riverspy/riverspy5/README.md

# riverspy5
Riverspy system based on the arduino compatible GBoard800, a custom daugher-board pcb which pushes onto the GBoard and either a tfmini LIDAR sensor or else a submersible differential pressure sensor.

Find the latest code on Github:
https://github.com/riverspy/riverspy5
