riverspy/riverspy5/hardware/daughter-board.png

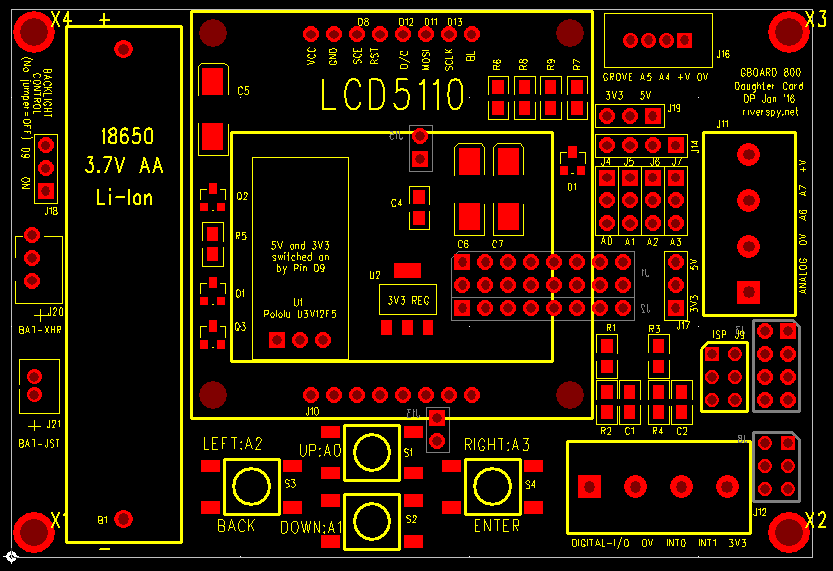
hardware/daughter-board.png
