riverspy/riverspy5/hardware/RiverSpy5-BOM.xls

Sheet: Sheet1
NOTES:
1, Manufacture Part Number is critical. Customers should provide the exact MPN.
2, Components Supplier: Digi-Key，Mouser，Element14，Chip One Stop，Verical，P&S，MCM，Newark，Gerber，Future，Avnet Arrow，Wpi，Master，Onlinecomponents.com，TTI，Garrett，4Stat，Allied，AIPCO，Sierra IC，Advanced MP Technology，Components Direct，Bristol，Bisco，Quest Components，Area51，Coilcraft
3, We only source components from the listed suppliers. If the components can not be sourced from the above suppliers, customers should find a replacement or ship the components to us.
4, We recommend to use Yageo resistors, we can get a better price for customers. Here's the part number:
http://www.digikey.com/product-search/en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
http://www.digikey.com/product-search/en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
Ref | Value | Footprint | Manufacture | Manufacture Part Number | Quantity | Specification
C1, C9, C12, C13, C15, C18, C25, C26, C27 | 10uF,10%,50 V | 1210 | AVX | 12105C106KAT2A | 9 | http://no.farnell.com/avx/12105c106kat2a/cap-mlcc-x7r-10uf-50v-1210/dp/2094047?ost=2094047
C2, C3, C4, C7, C14, C35, C36, C39, C42, C43, C46 | 47uF, 20%, 16V | 1210 | KEMET | C1210C476M4PACTU | 11 | http://no.farnell.com/kemet/c1210c476m4pactu/cap-mlcc-x5r-47uf-16v-1210/dp/1838761?ost=1838761
D1-D24, D37-D48, D50 | SCHOTTKY, 5A, 40V | SOD-128 | NXP | PMEG4050EP | 37 | http://no.farnell.com/nxp/pmeg4050ep/diode-schottky-5a-40v-sod-128/dp/1829203?Ntt=1829203
D49 | SCHOTTKY, 1A, 45V | SMA | VISHAY | BYS10-45-E3/TR | 1 | http://no.farnell.com/vishay/bys10-45-e3-tr/diode-schottky-1a-45v-sma/dp/1815642?Ntt=1815642
LED3, 5, 7, 9, 11, 13, 21, 23, 25, 28 | SMD, GREEN | 1206 | KINGBRIGHT | KP-3216MGC | 10 | http://no.farnell.com/kingbright/kp-3216mgc/led-smd-1206-green/dp/8529981?Ntt=8529981
U1 | REG LDO, 3.3V, 1.5A | DPAK | STMICROELECTRONICS | LD29150DT33R | 1 | http://no.farnell.com/stmicroelectronics/ld29150dt33r/ic-reg-ldo-3-3v-1-5a-dpak/dp/1564308?Ntt=1564308
R1,R2,R3 | RES 1K OHM 1/10W 5% 0603 SMD | 0603 | YAGEO | RC0603JR-071KL | 3 | http://www.digikey.com/product-detail/en/RC0603JR-071KL/311-1.0KGRCT-ND/729624

Sheet: Sheet2
Item | Qty | Reference | Part Name | Value | Footprint | Manufacturer | Part No | Specification
1 | 1 | Q1 | 2N7002LT1 | MOSFET N-ch 300mA 60V | SOT-23 | NXP | 2N7002,215 | http://ie.farnell.com/nxp/2n7002-215/mosfet-n-ch-60v-0-3a-sot23/dp/1510761
2 | 1 | Q3 | 2N7002LT1 | MOSFET N-ch 300mA 60V | SOT-23 | NXP | 2N7002,215 | http://ie.farnell.com/nxp/2n7002-215/mosfet-n-ch-60v-0-3a-sot23/dp/1510761
3 | 1 | B1 | BAT-AA | Single AA battery holder | 52mm pitch | Keystone | 2460 | http://ie.farnell.com/keystone/2460/battery-holder/dp/1702629
4 | 1 | D1 | BAT721C | Dual Schottky | SOT-23 | NXP | BAT721C | http://ie.farnell.com/nxp/bat721c/diode-schottky-dual/dp/1081199
5 | 1 | Q2 | BSS308PE | MOSFET P-ch -2A -30V | SOT-23 | Infineon | BSS308PE H6327 | http://ie.farnell.com/infineon/bss308pe-h6327/mosfet-p-ch-30v-2a-sot-23-3/dp/2432719
6 | 1 | C1 | CAP0805 | 10nF 50V Ceramic | 0805 | MultiComp | MC0805B103K500CT | http://ie.farnell.com/multicomp/mc0805b103k500ct/cap-mlcc-x7r-10nf-50v-0805/dp/1759246
7 | 1 | C2 | CAP0805 | 10nF 50V Ceramic | 0805 | MultiComp | MC0805B103K500CT | http://ie.farnell.com/multicomp/mc0805b103k500ct/cap-mlcc-x7r-10nf-50v-0805/dp/1759246
8 | 1 | C4 | CAP0805 | 10nF 50V Ceramic | 0805 | MultiComp | MC0805B103K500CT | http://ie.farnell.com/multicomp/mc0805b103k500ct/cap-mlcc-x7r-10nf-50v-0805/dp/1759246
9 | 1 | C5 | CAP6032 | 22uF 16V Tantalum | 2312 | Kemet | T491C226K016AT | http://ie.farnell.com/kemet/t491c226k016at/cap-tant-22uf-16v-case-c/dp/1457474
10 | 1 | C6 | CAP6032 | 22uF 16V Tantalum | 2312 | Kemet | T491C226K016AT | http://ie.farnell.com/kemet/t491c226k016at/cap-tant-22uf-16v-case-c/dp/1457474
11 | 1 | C7 | CAP6032 | 22uF 16V Tantalum | 2312 | Kemet | T491C226K016AT | http://ie.farnell.com/kemet/t491c226k016at/cap-tant-22uf-16v-case-c/dp/1457474
12 | 1 | J2 | HEADER08 | Receptacle 8x1 pins h:8.5mm | SIL-8 | MultiComp | 2212S-08SG-85 | http://ie.farnell.com/multicomp/2212s-08sg-85/socket-pcb-1-row-8way/dp/1593463?ost=1593463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
13 | 1 | J16 | GROVE-4PIN | Grove 4-pin connector | SIL-4-2mm | Seeed Studio | 110990030 | http://eu.mouser.com/ProductDetail/Seeed-Studio/110990030/
14 | 1 | J13 | HEADER02 | Receptacle 2x1 pins h:8.5mm | SIL-2 | MultiComp | 2212S-02SG-85 | http://ie.farnell.com/multicomp/2212s-02sg-85/receptacle-tht-vertical-2-54mm/dp/1593458
15 | 1 | J15 | HEADER02 | Receptacle 2x1 pins h:8.5mm | SIL-2 | MultiComp | 2212S-02SG-85 | http://ie.farnell.com/multicomp/2212s-02sg-85/receptacle-tht-vertical-2-54mm/dp/1593458
16 | 1 | J4 | HEADER03 | Header 3x1 pins | SIL-3 | Harwin | M20-9990346 | http://ie.farnell.com/harwin/m20-9990346/connector-header-tht-2-54mm-3way/dp/1022249
17 | 1 | J5 | HEADER03 | Header 3x1 pins | SIL-3 | Harwin | M20-9990346 | http://ie.farnell.com/harwin/m20-9990346/connector-header-tht-2-54mm-3way/dp/1022249
18 | 1 | J6 | HEADER03 | Header 3x1 pins | SIL-3 | Harwin | M20-9990346 | http://ie.farnell.com/harwin/m20-9990346/connector-header-tht-2-54mm-3way/dp/1022249
19 | 1 | J7 | HEADER03 | Header 3x1 pins | SIL-3 | Harwin | M20-9990346 | http://ie.farnell.com/harwin/m20-9990346/connector-header-tht-2-54mm-3way/dp/1022249
20 | 1 | J17 | HEADER03 | Header 3x1 pins | SIL-3 | Harwin | M20-9990346 | http://ie.farnell.com/harwin/m20-9990346/connector-header-tht-2-54mm-3way/dp/1022249
21 | 1 | J18 | HEADER03 | Header 3x1 pins | SIL-3 | Harwin | M20-9990346 | http://ie.farnell.com/harwin/m20-9990346/connector-header-tht-2-54mm-3way/dp/1022249
22 | 1 | J19 | HEADER03 | Header 3x1 pins | SIL-3 | Harwin | M20-9990346 | http://ie.farnell.com/harwin/m20-9990346/connector-header-tht-2-54mm-3way/dp/1022249
23 | 1 | J14 | HEADER04 | Header 4x1 pins | SIL-4 | Harwin | M20-9990446 | http://ie.farnell.com/harwin/m20-9990446/header-1row-4way/dp/1022251
24 | 1 | J1 | HEADER16-DIL | Receptacle 8x2 pins h:8.5mm | DIL-8 | Harwin | M20-7830846 | http://ie.farnell.com/harwin/m20-7830846/socket-pcb-0-1-8-8way/dp/7992017
25 | 1 | J8 | HEADER06-DIL | Receptacle 3x2 pins h:8.5mm | DIL-6 | Harwin | M20-7830346 | http://ie.farnell.com/harwin/m20-7830346/socket-pcb-0-1-3-3way/dp/7991983
26 | 1 | J9 | HEADER06-DIL | Header 3x2 pins | DIL-6 | Harwin | M20-9980346 | http://ie.farnell.com/harwin/m20-9980346/connector-header-tht-2-54mm-6way/dp/1022231
27 | 1 | J3 | HEADER08-DIL | Header 4x2 pins | DIL-8 | Harwin | M20-9980446 | http://ie.farnell.com/harwin/m20-9980446/header-2row-4way/dp/1022233
28 | 1 | J21 | JST-PH2 | Connector 2-pin 2.0mm | JST-PH2 | JST | B2B-PH-K-S(LF)(SN) | http://ie.farnell.com/jst-japan-solderless-terminals/b2b-ph-k-s-lf-sn/header-top-entry-2way-2mm/dp/9491856
29 | 1 | J20 | JST-XH2 | Connector 2-pin 2.5mm | JST-XH2 | JST | B2B-XH-A (LF)(SN) | http://ie.farnell.com/jst-japan-solderless-terminals/b2b-xh-a-lf-sn/header-vertical-2way/dp/1516276
30 | 1 | J10 | LCD5110 | Nokia LCD Display | 45x45mm | ITEAD | IM120424001 | https://www.itead.cc/nokia-5110-lcd.html
31 | 1 | J10a | HEADER08 | Receptacle 8x1 pins h:8.5mm | SIL-8 | MultiComp | 2212S-08SG-85 | http://ie.farnell.com/multicomp/2212s-08sg-85/socket-pcb-1-row-8way/dp/1593463?ost=1593463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
32 | 1 | J10b | HEADER08 | Receptacle 8x1 pins h:8.5mm | SIL-8 | MultiComp | 2212S-08SG-85 | http://ie.farnell.com/multicomp/2212s-08sg-85/socket-pcb-1-row-8way/dp/1593463?ost=1593463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
33 | 1 | U2 | MCP1824S | 3.3V Low dropout regulator | SOT-223 | Microchip | MCP1824ST-3302E/DB | http://ie.farnell.com/microchip/mcp1824st-3302e-db/ic-ldo-reg-0-3a-3-3v-3-sot223/dp/1578379RL
34 | 1 | U1 | STEP-UP-5V | 3 terminal step-up regulator 1A | TO-220 | POLOLU | U3V12F5 | https://www.pololu.com/product/2115
35 | 1 | R1 | RES0805 | 15k 1% | 0805
36 | 1 | R2 | RES0805 | 33k 1% | 0805
37 | 1 | R3 | RES0805 | 15k 1% | 0805
38 | 1 | R4 | RES0805 | 33k 1% | 0805
39 | 1 | R5 | RES0805 | 10k 5% | 0805
40 | 1 | R6 | RES0805 | 470R 5% | 0805
41 | 1 | R7 | RES0805 | 470R 5% | 0805
42 | 1 | R8 | RES0805 | Do not populate
43 | 1 | R9 | RES0805 | Do not populate
44 | 1 | S1 | SW-SMD | Tactile SMD pushbutton switch | 10x6.25mm | C&K Components | KSEK43G LFS | http://ie.farnell.com/c-k-components/ksek43g-lfs/tactile-switch-spst-0-05a-32vdc/dp/2435308
45 | 1 | S2 | SW-SMD | Tactile SMD pushbutton switch | 10x6.25mm | C&K Components | KSEK43G LFS | http://ie.farnell.com/c-k-components/ksek43g-lfs/tactile-switch-spst-0-05a-32vdc/dp/2435308
46 | 1 | S3 | SW-SMD | Tactile SMD pushbutton switch | 10x6.25mm | C&K Components | KSEK43G LFS | http://ie.farnell.com/c-k-components/ksek43g-lfs/tactile-switch-spst-0-05a-32vdc/dp/2435308
47 | 1 | S4 | SW-SMD | Tactile SMD pushbutton switch | 10x6.25mm | C&K Components | KSEK43G LFS | http://ie.farnell.com/c-k-components/ksek43g-lfs/tactile-switch-spst-0-05a-32vdc/dp/2435308
48 | 1 | J11 | TERM-4WAY | 4-way terminal block p:5.08mm | 20.3x11mm | Camdenboss | CTB0708/4 | http://ie.farnell.com/camdenboss/ctb0708-4/terminal-block-wire-to-brd-4pos/dp/2315275
49 | 1 | J12 | TERM-4WAY | 4-way terminal block p:5.08mm | 20.3x11mm | Camdenboss | CTB0708/4 | http://ie.farnell.com/camdenboss/ctb0708-4/terminal-block-wire-to-brd-4pos/dp/2315275
