riverspy/riverspy5/(threads)

Thread 1 (2020-11-07):

Server Logfile gets unusably big

sirtet, 2020-11-07:
http://www.riverspy.net/log00010.html
is so big, currently 4.5mb, it makes my mobile Chrome crash.
Could we have less output by default, or simply delete it (partially?) for now?

sirtet, 2020-11-07:
A very simple fix could also be to invert the output, aka newest values on top.

Thread 3 (2020-11-07):

Lidar alternatives

sirtet, 2020-11-07:
The Tf Mini Lidar module has a few problems for our application:

- The Wavelength of 850nm penetrates the water, so the readings are inherently inaccurate.
- The range is "max. 12m", but already at 5m the readings start to get erratic. Reading from a bridge, 10m is quickly needed.
- Day/Night can cause a lot of errors too.

Possible alternatives:
- DIY Module for 58$ with higher range and TTL-serial, but shorter Wavelength (635nm):
https://www.amazon.com/dp/B07G4F14RR/

- 30$ laser measuring tool UT390B with UART and Arduino library
https://github.com/erniejunior/UT390B_Arduino_Library

- 20$ laser measuring tool X40 with hacked firmware
https://www.hackster.io/iliasam/making-a-cheap-laser-rangefinder-for-arduino-4dd849

- 200€ Module with 905nm Laser
https://www.tinkerforge.com/en/doc/Hardware/Bricklets/Laser_Range_Finder_V2.html
