riverspy/riverspy5/hardware/RiverSpy5.pdf

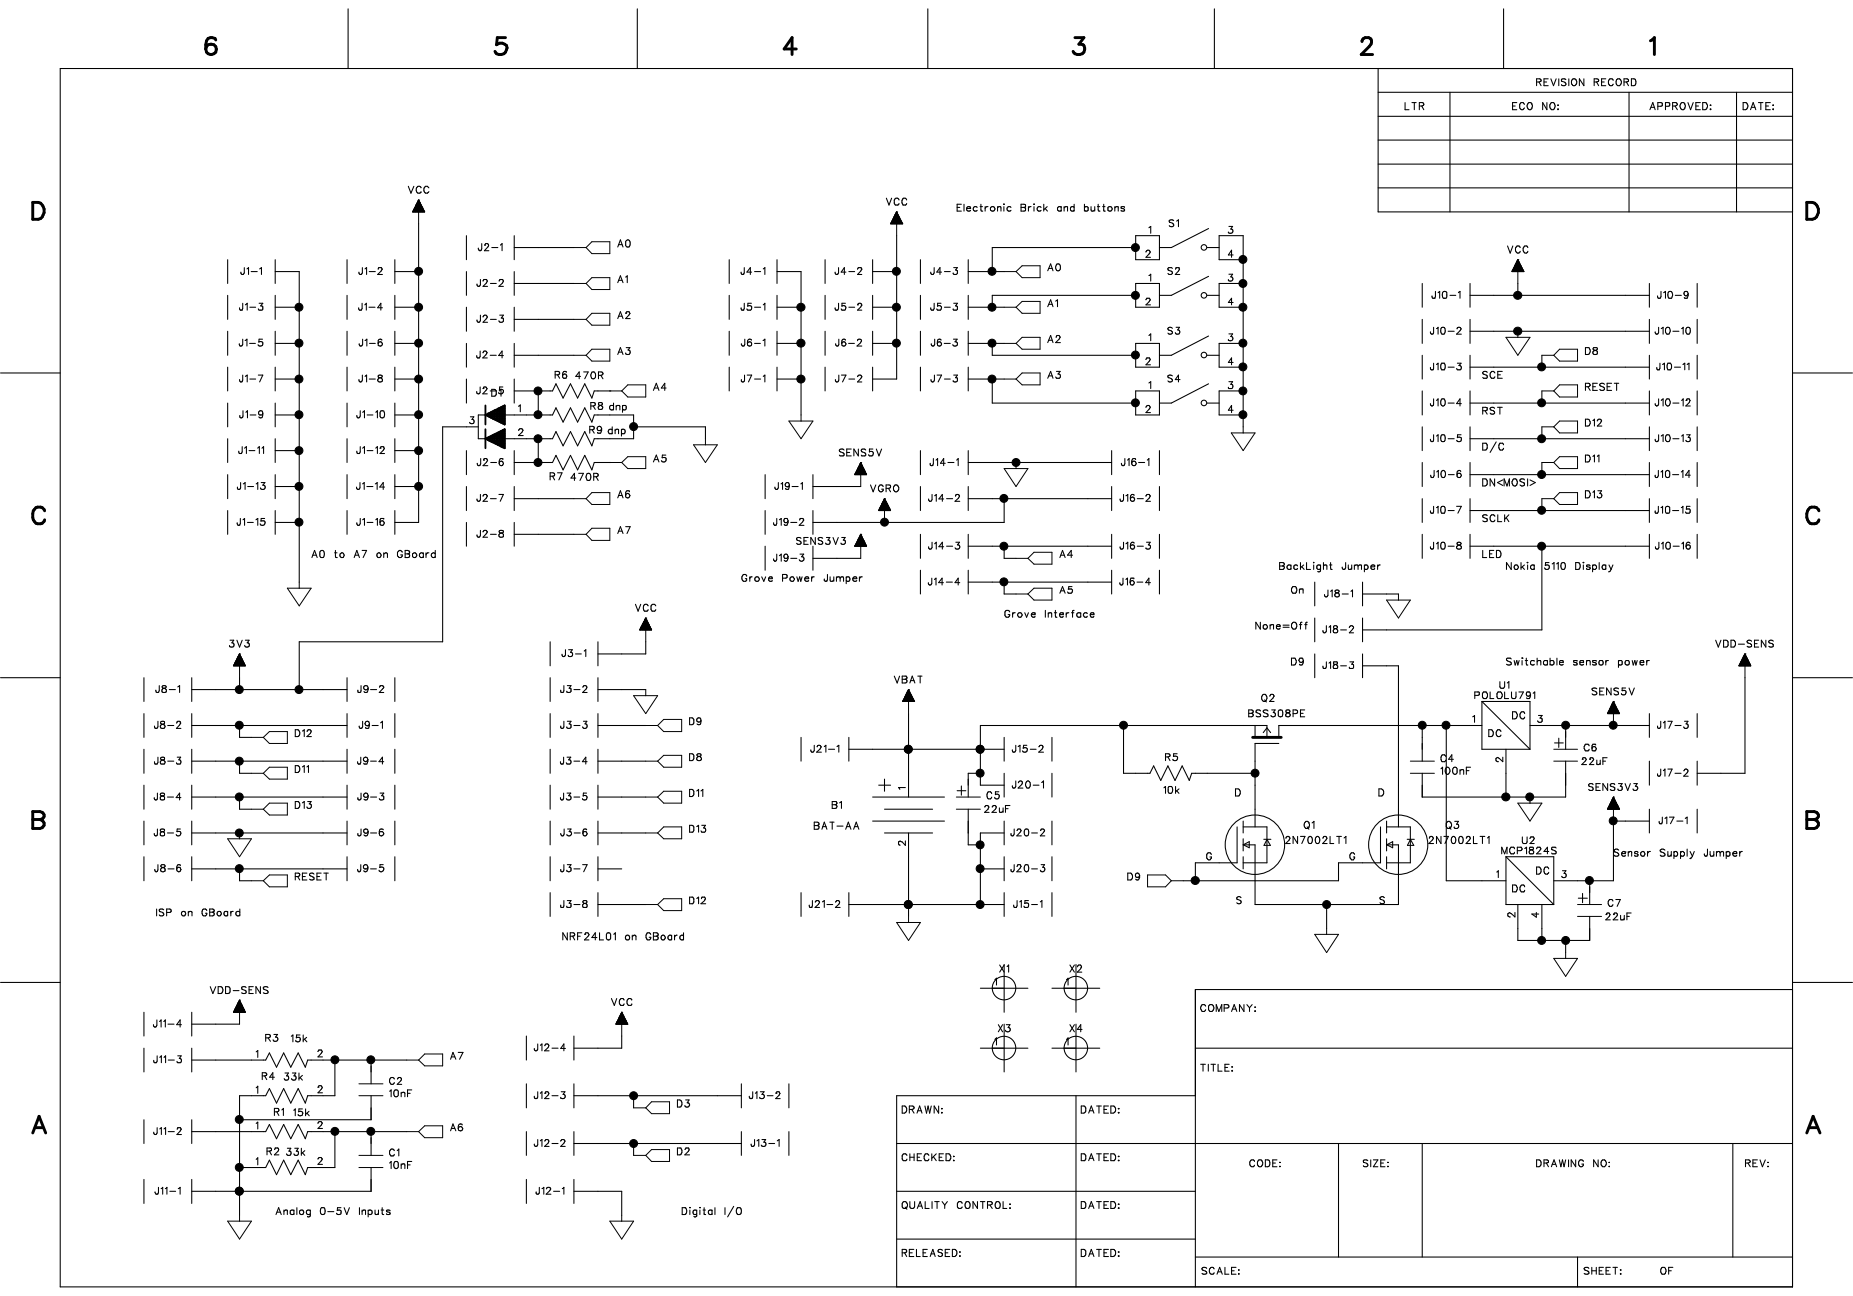
[picture p2: page 1]
