riverspy/riverspy5/(commit log)

2019-09-05 rename file, Arduino IDE needs the same folder- and sketch- name
2019-09-19 v5.05
    Updated riverspy5.ino to check the current time is valid at the end of the regular update routine and read the from the server if nexessary.
2019-10-22 Added extra LIDAR range checking
